hjhhch416/Industrial-Patrol-Robot-based-on-SLAM-and-CAN-Network/images/F1_curve.png

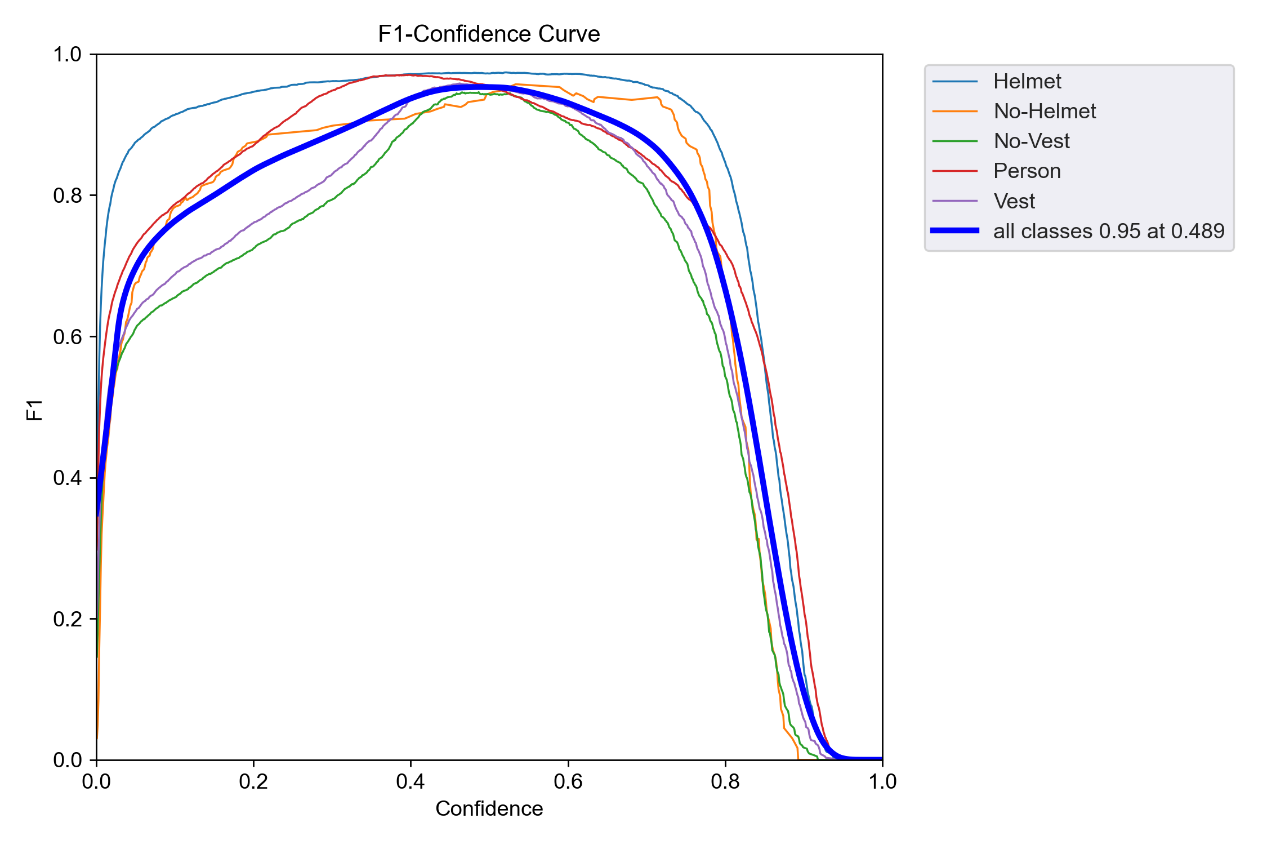
images/F1_curve.png
