hjhhch416/Industrial-Patrol-Robot-based-on-SLAM-and-CAN-Network/images/KakaoTalk_20260309_152843172_01.jpg

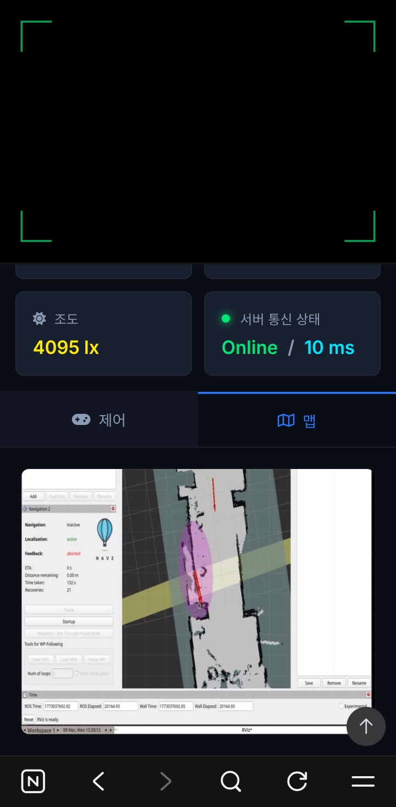
images/KakaoTalk_20260309_152843172_01.jpg
