hjhhch416/Industrial-Patrol-Robot-based-on-SLAM-and-CAN-Network/images/labels.jpg

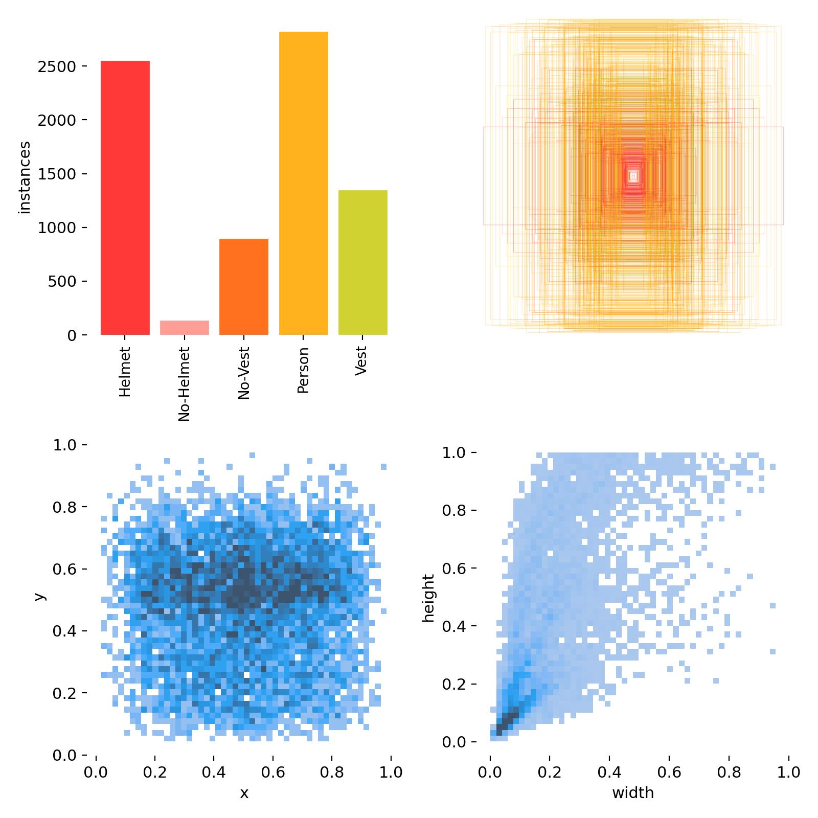
images/labels.jpg
