hjhhch416/Industrial-Patrol-Robot-based-on-SLAM-and-CAN-Network/images/labels_correlogram.jpg

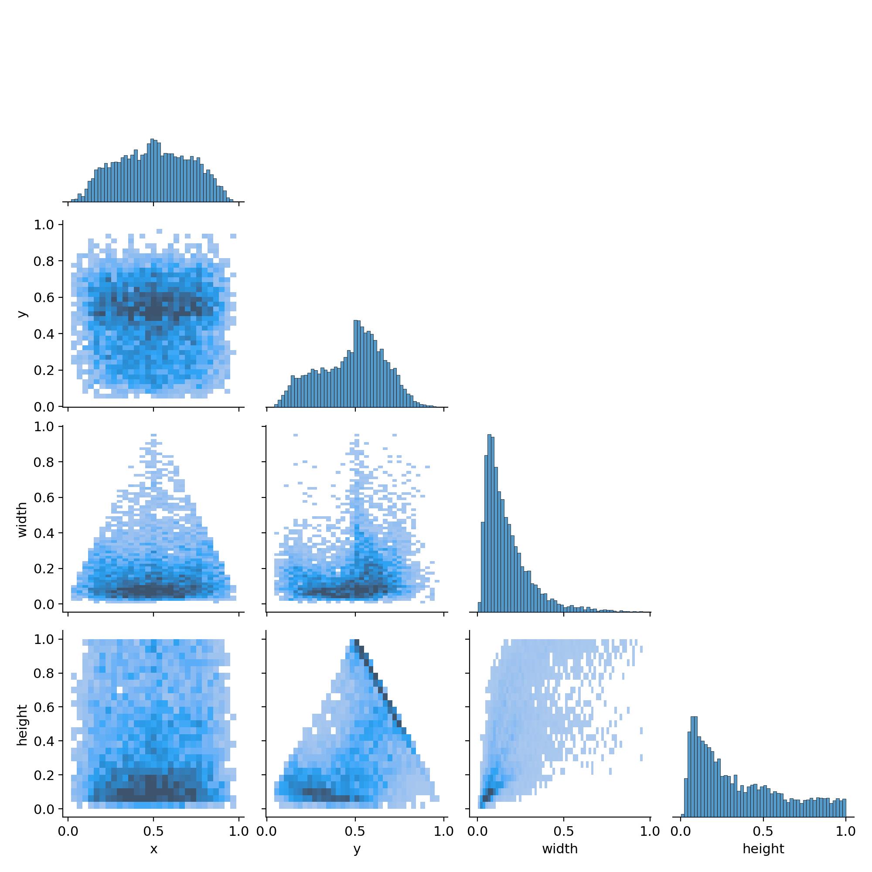
images/labels_correlogram.jpg
