hjhhch416/Industrial-Patrol-Robot-based-on-SLAM-and-CAN-Network/images/P_curve.png

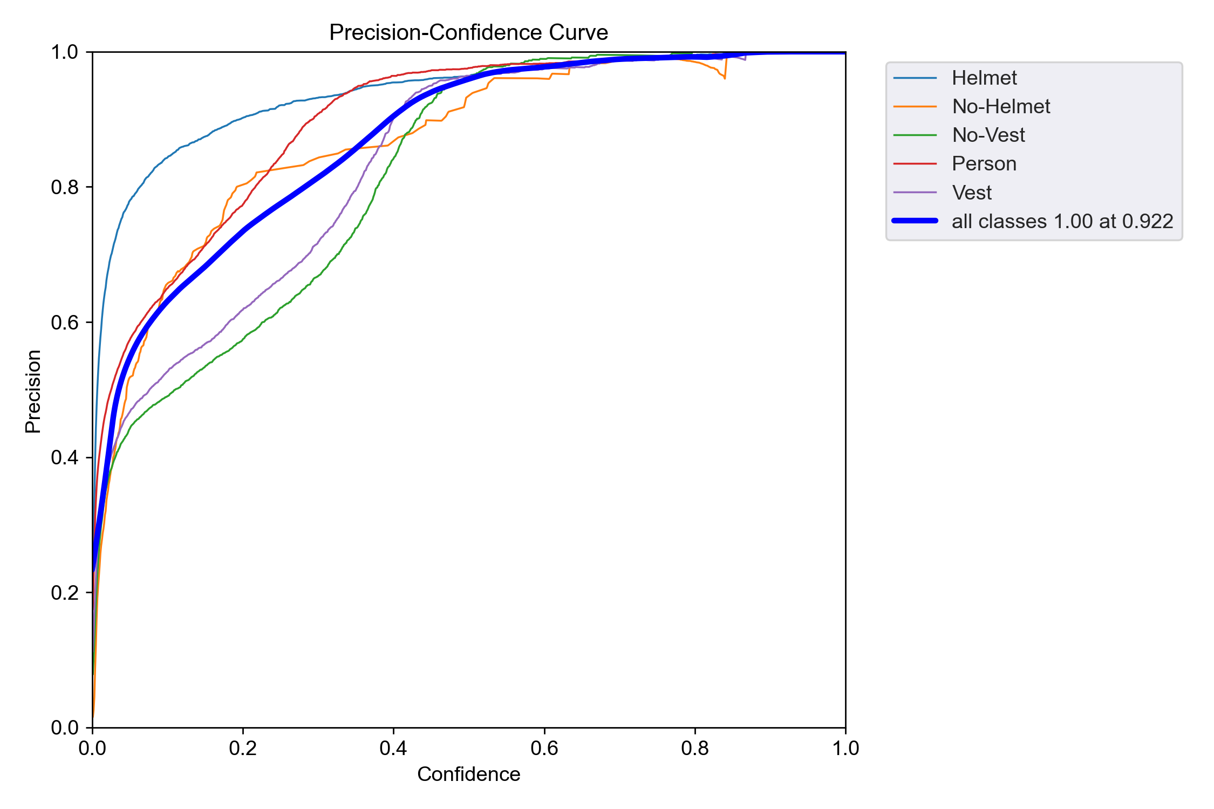
images/P_curve.png
