hjhhch416/Industrial-Patrol-Robot-based-on-SLAM-and-CAN-Network/images/PR_curve.png

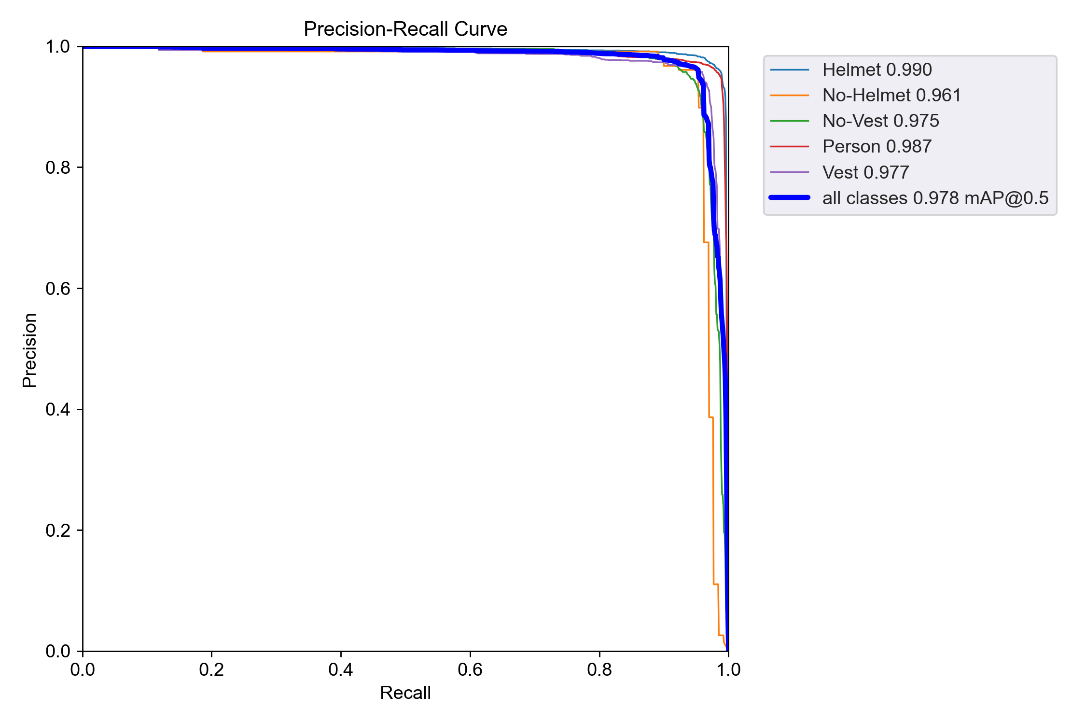
images/PR_curve.png
