hjhhch416/Industrial-Patrol-Robot-based-on-SLAM-and-CAN-Network/images/R_curve.png

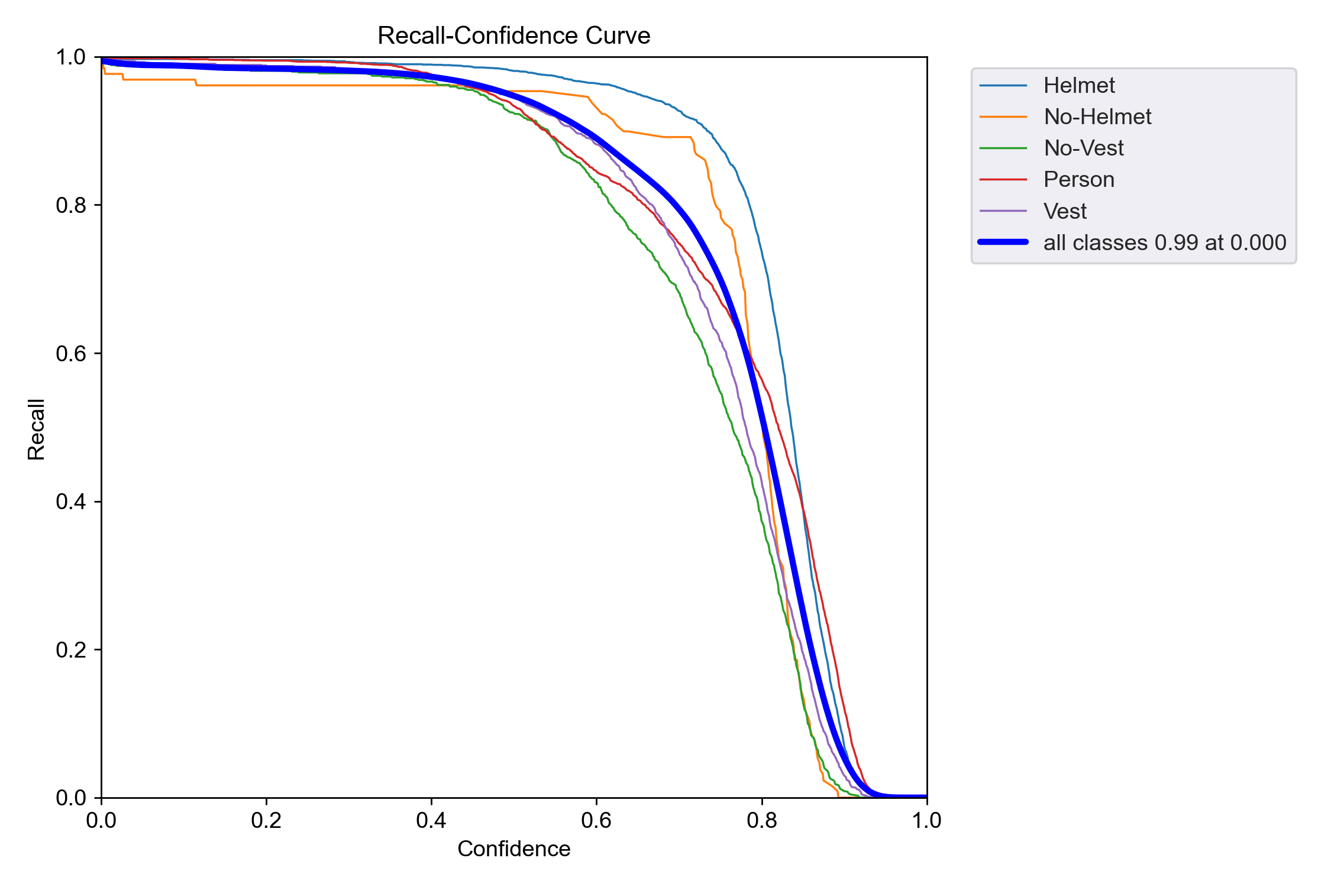
images/R_curve.png
