hjhhch416/Industrial-Patrol-Robot-based-on-SLAM-and-CAN-Network/images/udp 전송 로그 값2.png

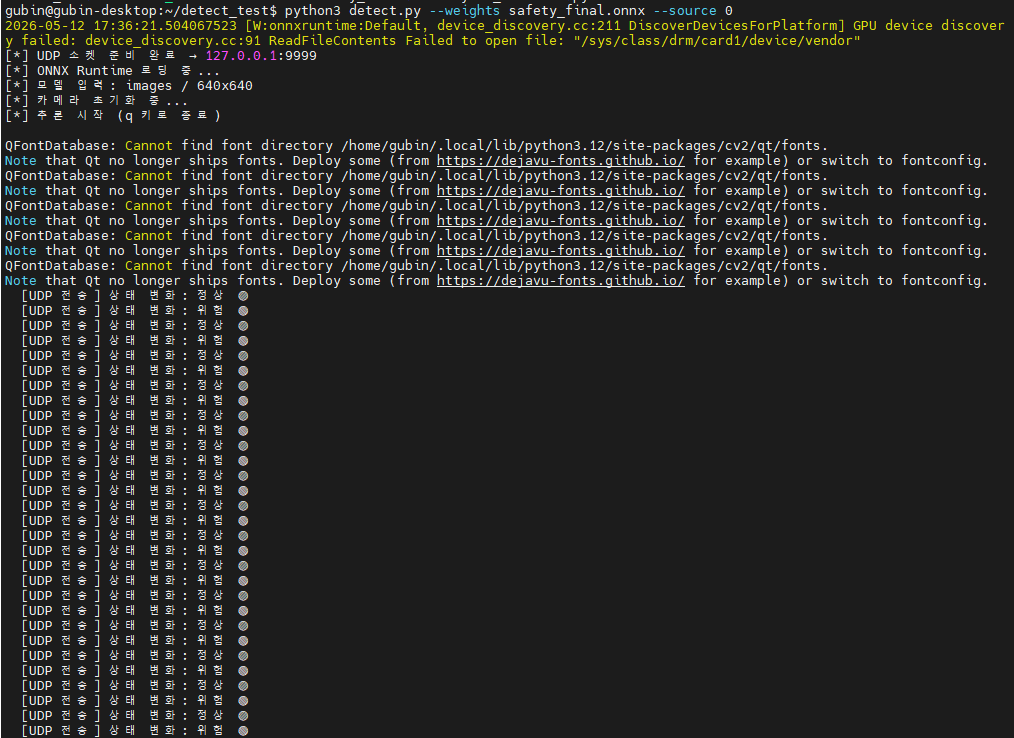
images/udp 전송 로그 값2.png
