hjhhch416/Industrial-Patrol-Robot-based-on-SLAM-and-CAN-Network/images/안전모만 쓴 상태.png

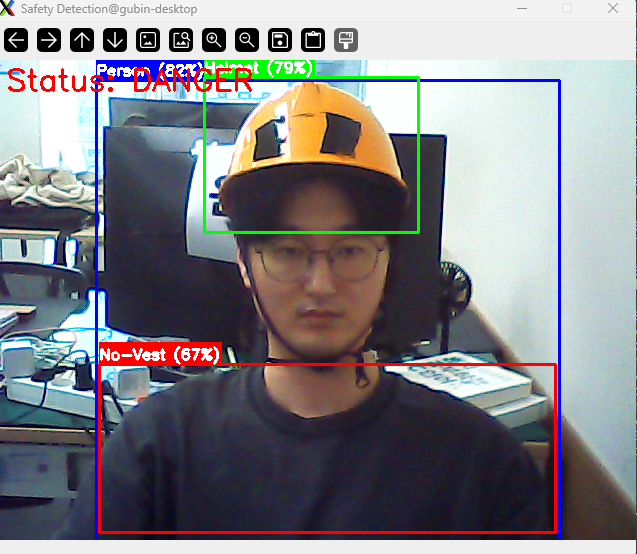
images/안전모만 쓴 상태.png
