hjhhch416/Industrial-Patrol-Robot-based-on-SLAM-and-CAN-Network/images/안전장비 다 착용 안한 상태.png

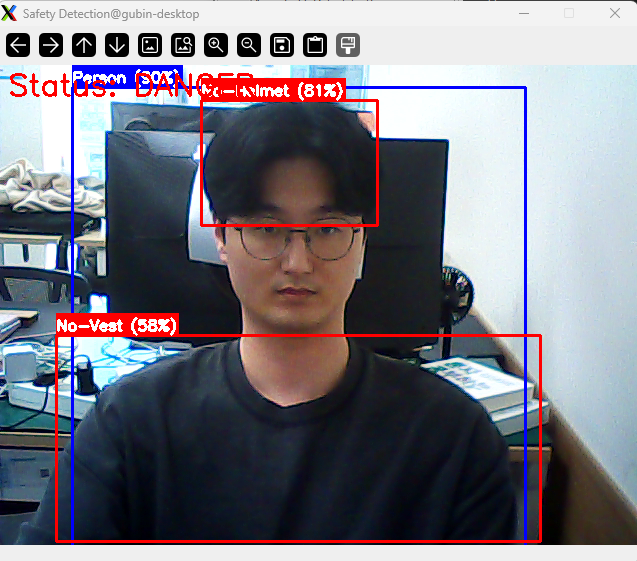
images/안전장비 다 착용 안한 상태.png
