hjhhch416/Industrial-Patrol-Robot-based-on-SLAM-and-CAN-Network/images/results.png

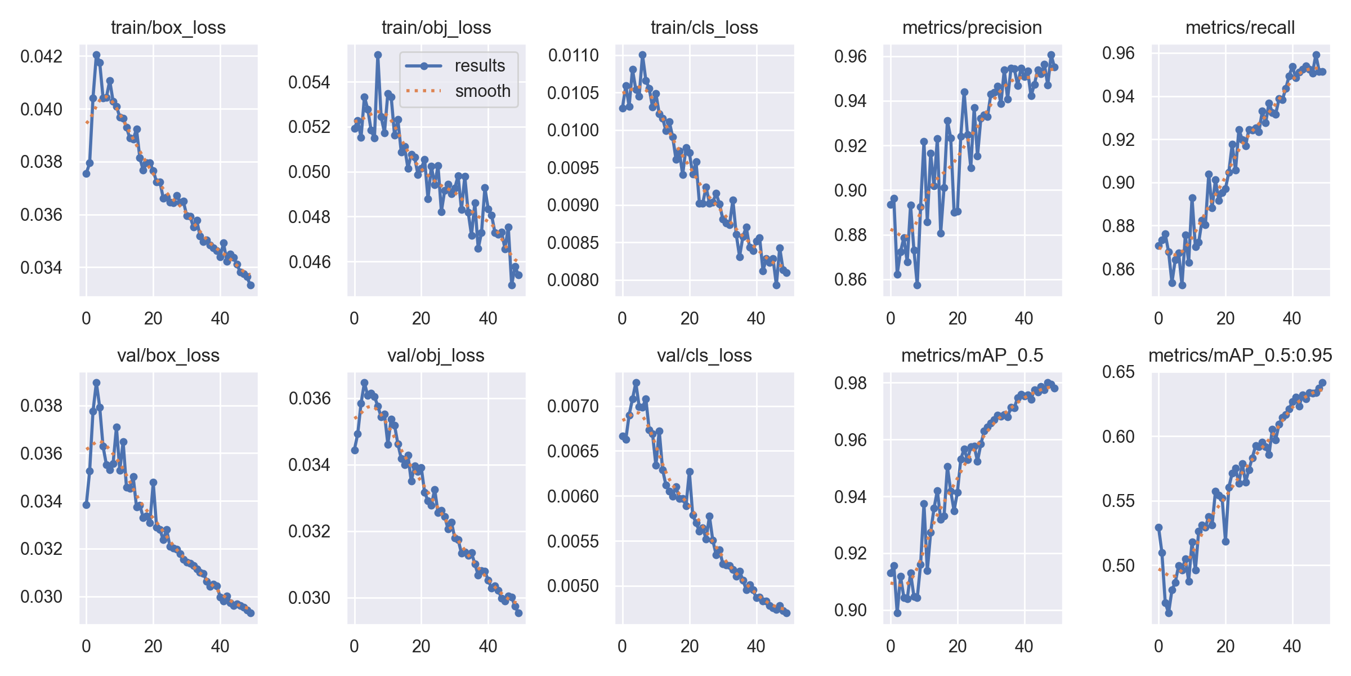
images/results.png
