hjhhch416/Industrial-Patrol-Robot-based-on-SLAM-and-CAN-Network/ROBOT_FUNC/Core/Src/main.c

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
/* Includes ------------------------------------------------------------------*/
#include "main.h"
#include "string.h"

/* USER CODE BEGIN Includes */
#include "led.h"
#include "warning_led.h"
#include "buzzer.h"
#include "can.h"
/* USER CODE END Includes */


ETH_TxPacketConfig TxConfig;
ETH_DMADescTypeDef  DMARxDscrTab[ETH_RX_DESC_CNT]; /* Ethernet Rx DMA Descriptors */
ETH_DMADescTypeDef  DMATxDscrTab[ETH_TX_DESC_CNT]; /* Ethernet Tx DMA Descriptors */

ADC_HandleTypeDef hadc1;

CAN_HandleTypeDef hcan1;

ETH_HandleTypeDef heth;

TIM_HandleTypeDef htim1;
TIM_HandleTypeDef htim2;
TIM_HandleTypeDef htim3;

UART_HandleTypeDef huart3;

PCD_HandleTypeDef hpcd_USB_OTG_FS;

/* USER CODE BEGIN PV */
uint8_t app_mode = 0; // 0:auto 1:manual

uint16_t adcValue = 0;

uint8_t rgb_led_state = 0;    // 0: OFF, 1: ON
uint8_t red_led_state = 0;    // 0: OFF, 1: ON
uint8_t buzzer_state = 0;     // 0: OFF, 1: ON
//uint16_t buzzer_duty = 0;   // 필요하면 부저 세기까지 저장
uint8_t manual_rgb_req = 0;  // 수동 RGB ON/OFF 요청
/* USER CODE END PV */

void SystemClock_Config(void);
static void MX_GPIO_Init(void);
static void MX_ETH_Init(void);
static void MX_USART3_UART_Init(void);
static void MX_USB_OTG_FS_PCD_Init(void);
static void MX_ADC1_Init(void);
static void MX_TIM1_Init(void);
static void MX_TIM2_Init(void);
static void MX_TIM3_Init(void);
static void MX_CAN1_Init(void);
/* USER CODE BEGIN 0 */
const uint16_t dark_th = 2000;   // 너 환경에 맞게 조절
const uint16_t white_intensity = 999; // 흰색 밝기(0~999)

static void update_rgb_led(void)
{
    if (app_mode == 0) // AUTO
    {
        if (adcValue < dark_th)
        {
            LED_White(white_intensity);
            rgb_led_state = 1;
        }
        else
        {
            LED_Off();
            rgb_led_state = 0;
        }
    }
    else // MANUAL
    {
        if (manual_rgb_req)
        {
            LED_White(white_intensity);
            rgb_led_state = 1;
        }
        else
        {
            LED_Off();
            rgb_led_state = 0;
        }
    }
}

static void app_can_rx_cb(uint32_t id, const uint8_t *data, uint8_t dlc)
{
    (void)dlc;

    switch (id)
    {

    case CAN_ID_RX_MODE:
        app_mode = data[0];   // 0:auto 1:manual
        break;

    case CAN_ID_RX_RGB:
        manual_rgb_req = data[0]; // 0 OFF / 1 ON
        break;

    case CAN_ID_RX_LED:
        if (data[0])
        {
            WarningLed_On();
            red_led_state = 1;
        }
        else
        {
            WarningLed_Off();
            red_led_state = 0;
        }
        break;

    case CAN_ID_RX_BUZZER:
        if (data[0])
        {
            Buzzer_On(500);
            buzzer_state = 1;
        }
        else
        {
            Buzzer_Off();
            buzzer_state = 0;
        }
        break;

    default:
        break;
    }

    update_rgb_led();
}

/* USER CODE END 0 */

/**
  * @brief  The application entry point.
  * @retval int
  */
int main(void)
{

  /* MCU Configuration--------------------------------------------------------*/

  /* Reset of all peripherals, Initializes the Flash interface and the Systick. */
  HAL_Init();

  /* Configure the system clock */
  SystemClock_Config();

  /* Initialize all configured peripherals */
  MX_GPIO_Init();
  MX_ETH_Init();
  MX_USART3_UART_Init();
  MX_USB_OTG_FS_PCD_Init();
  MX_ADC1_Init();
  MX_TIM1_Init();
  MX_TIM2_Init();
  MX_TIM3_Init();
  MX_CAN1_Init();
  /* USER CODE BEGIN 2 */
  HAL_TIM_PWM_Start(&htim3, TIM_CHANNEL_1); // 부저
  HAL_TIM_PWM_Start(&htim1, TIM_CHANNEL_1); // RGB - Red
  HAL_TIM_PWM_Start(&htim1, TIM_CHANNEL_2); // RGB - Green
  HAL_TIM_PWM_Start(&htim1, TIM_CHANNEL_3); // RGB - Blue
  LED_Init();          // (led.c에 LED_Init이 있을 때)
  WarningLed_Init();
  Buzzer_Init();
  can_comm_init(&hcan1, app_can_rx_cb); // CAN 시작 + RX 알림 활성화 + 필터 설정
  /* USER CODE END 2 */

  /* Infinite loop */
  /* USER CODE BEGIN WHILE */
  while (1)
  {
  //  // ADC 읽기 (예: hadc1, 채널은 너 설정대로)
    HAL_ADC_Start(&hadc1);
    if (HAL_ADC_PollForConversion(&hadc1, 10) == HAL_OK) {
        adcValue = (uint16_t)HAL_ADC_GetValue(&hadc1); // 0~4095
    }
    
    HAL_ADC_Stop(&hadc1);
    update_rgb_led();
    can_comm_tx_status(adcValue,
                        rgb_led_state,
                        red_led_state,
                        buzzer_state);

    HAL_Delay(200);


  // 어두우면 흰색 ON, 밝으면 OFF
  //   if (adcValue < dark_th) {
  //       LED_White(white_intensity);
  //   } else {
  //       LED_Off();
  //   }

  //   if (triggered)
  //   {
  //       // 경고 동작
  //       WarningLed_On();
  //      // Buzzer_On(500);
  //   }
  //   else
  //   {
  //       // 평상시
  //       WarningLed_Off();
  //      // Buzzer_Off();
  //   }

  //   HAL_Delay(50);
    
    /* USER CODE END WHILE */

    /* USER CODE BEGIN 3 */
  }
  /* USER CODE END 3 */
}

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
/* USER CODE BEGIN 4 */
void HAL_CAN_RxFifo0MsgPendingCallback(CAN_HandleTypeDef *hcan)
{
  HAL_GPIO_TogglePin(GPIOB, LD1_Pin);  
  can_comm_rx_handler(hcan);
}
/* USER CODE END 4 */
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
