hjhhch416/Industrial-Patrol-Robot-based-on-SLAM-and-CAN-Network/ROBOT_FUNC/ROBOT_FUNC.ioc

Mcu.UserName=STM32F429ZITx
PA1.GPIO_Label=RMII_REF_CLK [LAN8742A-CZ-TR_REFCLK0]
PA1.Signal=ETH_REF_CLK
PA10.GPIO_Label=USB_ID
PA10.Signal=USB_OTG_FS_ID
PA11.GPIO_Label=USB_DM
PA11.Signal=USB_OTG_FS_DM
PA12.GPIO_Label=USB_DP
PA12.Signal=USB_OTG_FS_DP
PA13.GPIO_Label=TMS
PA13.Signal=SYS_JTMS-SWDIO
PA14.GPIO_Label=TCK
PA14.Signal=SYS_JTCK-SWCLK
PA2.GPIO_Label=RMII_MDIO [LAN8742A-CZ-TR_MDIO]
PA2.Signal=ETH_MDIO
PA3.GPIO_Label=photosensor
PA3.Signal=ADCx_IN3
PA7.GPIO_Label=RMII_CRS_DV [LAN8742A-CZ-TR_CRS_DV]
PA7.Signal=ETH_CRS_DV
PA8.GPIO_Label=USB_SOF [TP1]
PA8.Signal=USB_OTG_FS_SOF
PA9.GPIO_Label=USB_VBUS
PA9.Signal=USB_OTG_FS_VBUS
PB0.GPIO_Label=LD1 [Green]
PB0.Signal=GPIO_Output
PB10.GPIO_Label=servo
PB10.Signal=S_TIM2_CH3
PB13.GPIO_Label=RMII_TXD1 [LAN8742A-CZ-TR_TXD1]
PB13.Signal=ETH_TXD1
PB14.GPIO_Label=LD3 [Red]
PB14.Signal=GPIO_Output
PB4.GPIO_Label=buzzer
PB4.Signal=S_TIM3_CH1
PB7.GPIO_Label=LD2 [Blue]
PB7.Signal=GPIO_Output
PB8.Signal=CAN1_RX
PB9.Signal=CAN1_TX
PC1.GPIO_Label=RMII_MDC [LAN8742A-CZ-TR_MDC]
PC1.Signal=ETH_MDC
PC13.GPIO_Label=USER_Btn [B1]
PC13.Signal=GPXTI13
PC14/OSC32_IN.Signal=RCC_OSC32_IN
PC15/OSC32_OUT.Signal=RCC_OSC32_OUT
PC4.GPIO_Label=RMII_RXD0 [LAN8742A-CZ-TR_RXD0]
PC4.Signal=ETH_RXD0
PC5.GPIO_Label=RMII_RXD1 [LAN8742A-CZ-TR_RXD1]
PC5.Signal=ETH_RXD1
PD8.GPIO_Label=STLK_RX [STM32F103CBT6_PA3]
PD8.Signal=USART3_TX
PD9.GPIO_Label=STLK_TX [STM32F103CBT6_PA2]
PD9.Signal=USART3_RX
PE11.GPIO_Label=led_g
PE11.Signal=S_TIM1_CH2
PE13.GPIO_Label=led_b
PE13.Signal=S_TIM1_CH3
PE9.GPIO_Label=led_r
PE9.Signal=S_TIM1_CH1
PF15.GPIO_Label=red led
PF15.Signal=GPIO_Output
PG11.GPIO_Label=RMII_TX_EN [LAN8742A-CZ-TR_TXEN]
PG11.Signal=ETH_TX_EN
PG13.GPIO_Label=RMII_TXD0 [LAN8742A-CZ-TR_TXD0]
PG13.Signal=ETH_TXD0
PG6.GPIO_Label=USB_PowerSwitchOn [STMPS2151STR_EN]
PG6.Signal=GPIO_Output
PG7.GPIO_Label=USB_OverCurrent [STMPS2151STR_FAULT]
PG7.Signal=GPIO_Input
PH0/OSC_IN.GPIO_Label=MCO [STM32F103CBT6_PA8]
PH0/OSC_IN.Signal=RCC_OSC_IN
PH1/OSC_OUT.Signal=RCC_OSC_OUT
