hjhhch416/Industrial-Patrol-Robot-based-on-SLAM-and-CAN-Network/ROBOT_FUNC/Core/Src/buzzer.c

#include "buzzer.h"

extern TIM_HandleTypeDef htim3;

#define BUZ_MAX_DUTY (999U)

static inline uint16_t clamp_u16(uint16_t v, uint16_t maxv)
{
    return (v > maxv) ? maxv : v;
}

void Buzzer_Init(void)
{
    HAL_TIM_PWM_Start(&htim3, TIM_CHANNEL_1);
    Buzzer_Off();
}

void Buzzer_On(uint16_t duty)
{
    duty = clamp_u16(duty, BUZ_MAX_DUTY);
    __HAL_TIM_SET_COMPARE(&htim3, TIM_CHANNEL_1, duty);
}

void Buzzer_Off(void)
{
    __HAL_TIM_SET_COMPARE(&htim3, TIM_CHANNEL_1, 0);
}

void Buzzer_BeepTick(uint16_t duty, uint32_t duration_ms, uint32_t now_ms)
{
    static uint8_t active = 0;
    static uint32_t t0 = 0;

    duty = clamp_u16(duty, BUZ_MAX_DUTY);

    if (!active) {
        // 한 번 호출되면 비프 시작
        active = 1;
        t0 = now_ms;
        Buzzer_On(duty);
        return;
    }

    if ((now_ms - t0) >= duration_ms) {
        Buzzer_Off();
        active = 0;
    }
}
