hjhhch416/Industrial-Patrol-Robot-based-on-SLAM-and-CAN-Network/(commit log)

2026-03-23 웹 데시보드 + 서버 추가
2026-05-13 Revert "main 코드 설명 추가"
    This reverts commit f11e290fad0611291488d20f3722f349de6402a4.
    [ap.c, ap.h, can_comm.c, can_comm.h, main.c, main.h, motor.c]
2026-05-13 main 코드 설명 추가
2026-05-13 Update Readme with project overview and instructions
    Add detailed documentation for Raspberry Pi control program including features, system architecture, folder structure, and build instructions.
2026-05-13 Revise README for Raspberry Pi Integration Controller
    Updated the README to enhance clarity and organization with new headings and emojis.
2026-06-17 Enhance Readme with operation flow and details
    Add flowchart and update communication settings in Readme.
