hjhhch416/Industrial-Patrol-Robot-based-on-SLAM-and-CAN-Network/(notices)

Notices in the files:
ROBOT_FUNC/Core/Src/main.c:
Copyright (c) 2026 STMicroelectronics.
All rights reserved.
This software is licensed under terms that can be found in the LICENSE file
